taqi59a/EEB3-Big-Clock/clock frame.jpg

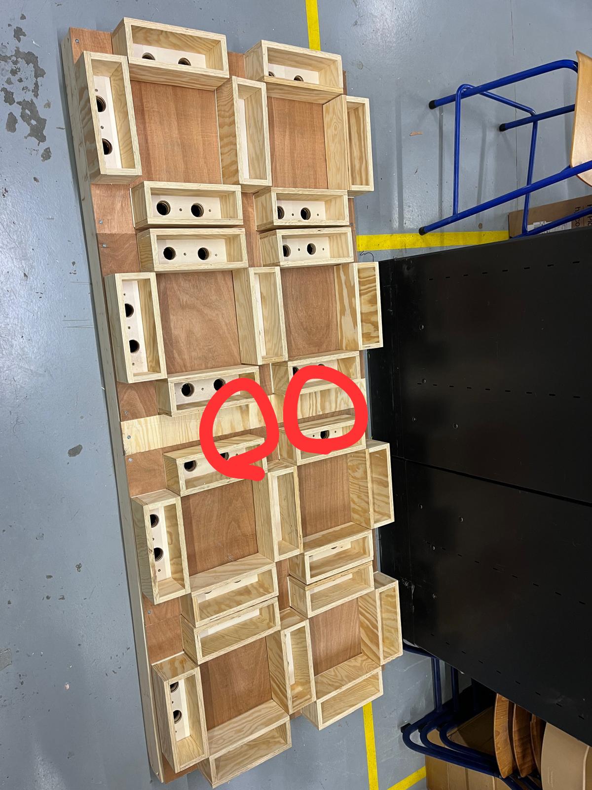
clock frame.jpg
