taqi59a/EEB3-Big-Clock/clock frame numbered.jpg

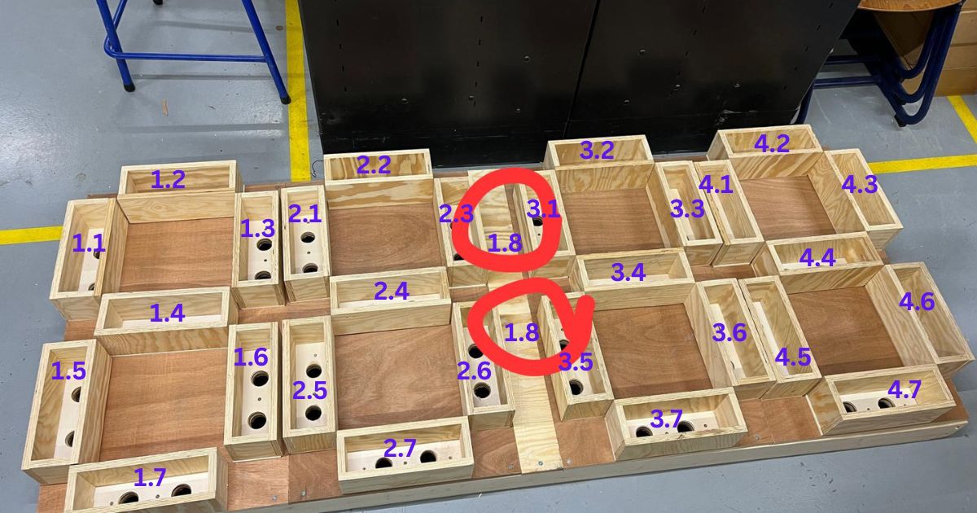
clock frame numbered.jpg
