taqi59a/EEB3-Big-Clock/clock mapping.png

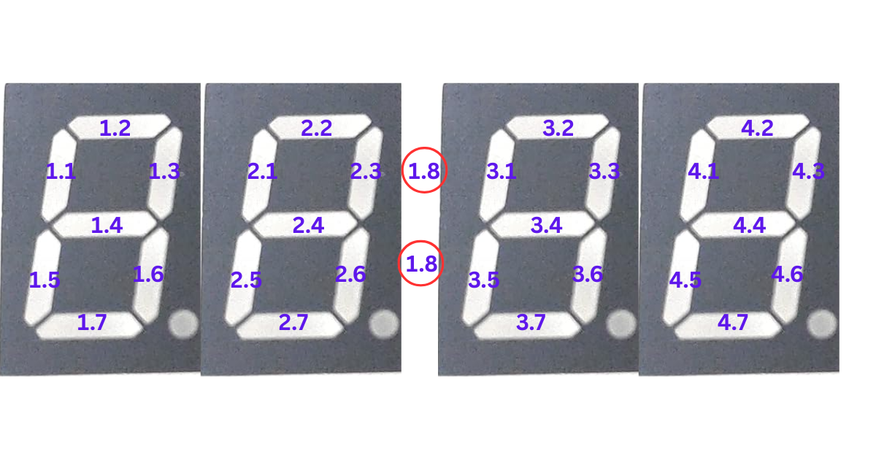
clock mapping.png
