taqi59a/EEB3-Big-Clock/(commit log)

2026-06-10 Initial commit: EEB3 big clock — 220V relay-driven 7-segment display
    Arduino MEGA 2560 + DS3231 RTC driving 4x 8-relay modules to switch
    220V light-bulb segments. Features Brussels DST, bell schedule P1-P9,
    operating hours 08:00-17:00, bulletproof two-stage RTC time sync,
    hardware watchdog, and relay change-tracking for long life.
2026-06-12 Extend EEb3/period display to 4+3 seconds; fix transition timing
    EEb3 now shows for 4 seconds (:53-:56) and period label for 3 seconds
    (:57-:59) instead of 1 second each. Same 3 relay transitions per minute
    but each display is long enough to read comfortably. Better for bulbs
    (fewer rapid on/off cycles) and better user experience.
    [generate_pdf.py]
2026-09-22 Add basic power-saving clock firmware with wiring diagnostics tool
    Simplifies the Mega relay firmware to the essentials: accurate HH:MM
    display, indefinite Brussels DST (EU last-Sunday rule recalculated
    every year), and an 08:00-17:00 power-saving window. Drops the period
    schedule and boot self-test, and fixes a Module 4 pin regression where
    IN3/IN6 (pins 48/51) had been swapped back to a previously broken
    mapping, causing segments b/c to swap on that digit.
    Adds a D0/D1 + R<module><index><state> serial protocol so individual
    relays can be fired on demand without disturbing the clock, and a
    companion clock_diagnostics.html that runs a standalone virtual clock
    in the browser and, over Web Se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
    [EEB3_Clock_Mega_Relay_PowerSaving.ino]
2026-09-25 Fix inverted relay logic (active-high, not active-low)
    The relay boards actually energize on a HIGH signal, but RELAY_ACTIVE_LOW
    was set true, so intended-ON commands (driven LOW) left relays
    de-energized and intended-OFF commands (driven HIGH) energized them —
    confirmed on the physical board where bulbs that should light stayed
    dark. Flipping the single flag corrects it everywhere it's used
    (writeRelay, boot-time pin init, and the boot log label).
    [EEB3_Clock_Mega_Relay_PowerSaving.ino]
2026-09-25 Clean up repo: remove build artifacts and stale planning docs
    - Add .gitignore for build/ and .DS_Store (compiled .hex/.elf output
    shouldn't be tracked)
    - Remove the superseded original EEB3_Clock_Mega_Relay sketch and the
    small segment test file, now replaced by the working
    EEB3_Clock_Mega_Relay_PowerSaving firmware
    - Delete task.md, implementation_plan.md, and walkthrough.md (stale
    planning docs from earlier sessions; walkthrough.md specifically
    documented the period-display feature that's since been removed)
    - Delete EEB3_Clock_Simulator.html (outdated: assumed active-low relay
    logic and documented the removed period/master-relay features;
    superseded by clock_diagnostics.htm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
    [set_rtc.py]
2026-09-25 Regenerate documentation to match current firmware (FW 4.3-DIAG)
    generate_pdf.py and generate_connections_pdf.py still embedded an old
    copy of the firmware (RELAY_ACTIVE_LOW=true, wrong Module 4 pin order,
    the removed period-schedule and master-relay features). Updated both
    generators to match EEB3_Clock_Mega_Relay_PowerSaving.ino exactly, and
    documented the new D0/D1/R wiring-diagnostic serial protocol plus
    clock_diagnostics.html in both. Regenerated EEB3_Clock_Reference.pdf
    and EEB3_Clock_Connections.pdf from the updated scripts.
    Also adds the remaining reference photos (clock frame/mapping images)
    that were already updated locally.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
    [generate_connections_pdf.py, generate_pdf.py]
